NicairolMedinaPayano/nicairol0921/Tarea 6/Etiqueta.jpg

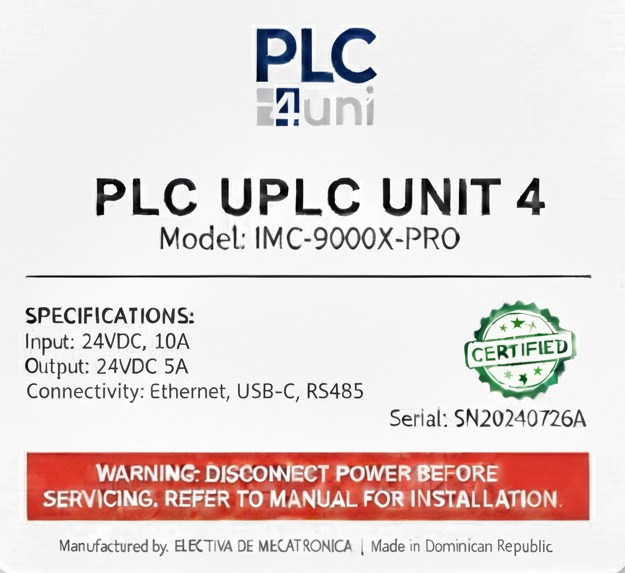
Tarea 6/Etiqueta.jpg
