NicairolMedinaPayano/nicairol0921/Tarea 1. Trabajo de investigación/DOC - Plantilla SRS ERS Norma IEEE-830 STD.docx

Especificación de requisitos de software

Proyecto: PLC 4 UNI

Revisión [99.99]

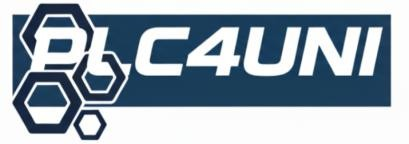
[picture p2: figure]

| 09/2025 [Mes de año]

Instrucciones para el uso de este formato

Este formato es una plantilla tipo para documentos de requisitos del software. Está basado y es conforme con el estándar IEEE Std 830-1998.

Las secciones que no se consideren aplicables al sistema descrito podrán de forma justificada indicarse como no aplicables (NA).

Notas:

Los textos en color azul son indicaciones que deben eliminarse y, en su caso, sustituirse por los contenidos descritos en cada apartado.

Los textos entre corchetes del tipo “[Inserte aquí el texto]” permiten la inclusión directa de texto con el color y estilo adecuado a la sección, al pulsar sobre ellos con el puntero del ratón.

Los títulos y subtítulos de cada apartado están definidos como estilos de MS Word, de forma que su numeración consecutiva se genera automáticamente según se trate de estilos “Titulo1, Titulo2 y Titulo3”.

La sangría de los textos dentro de cada apartado se genera automáticamente al pulsar Intro al final de la línea de título. (Estilos Normal indentado1, Normal indentado 2 y Normal indentado 3).

El índice del documento es una tabla de contenido que MS Word actualiza tomando como criterio los títulos del documento.

Una vez terminada su redacción debe indicarse a Word que actualice todo su contenido para reflejar el contenido definitivo.

De la plantilla de formato del documento © & Coloriuris http://www.qualitatis.org

# Ficha del documento

Fecha | Revisión | Autor | Verificado dep. calidad.
16/09/2025 | 16/09 | Nicairol Elian Medina Payano | [Firma o sello]

Documento validado por las partes en fecha: [Fecha]

Por el cliente | Por la empresa suministradora
Fdo. D./ Dña [Nombre] | Fdo. D./Dña [Nombre]

# Contenido

# 1 Introducción

El presente documento ofrece una descripción integral del sistema PLC 4 UNI, abarcando desde su propósito general hasta el funcionamiento operativo del sistema. La Especificación de Requisitos de Software (SRS) tiene como objetivo proporcionar una visión global del proyecto, definiendo su finalidad, alcance, terminología, referencias técnicas y estructura general.

Este documento consolida los requerimientos para el desarrollo de un Controlador Lógico Programable (PLC) diseñado con fines académicos, orientado a estudiantes que se inician en el campo de la automatización y el control industrial. Surge de la necesidad de disponer de una herramienta didáctica de bajo costo, confiable y sencilla de utilizar, que brinde la posibilidad de interactuar con un entorno de programación y control real.

El propósito fundamental del PLC 4 UNI es servir como un recurso formativo que fomente el aprendizaje práctico, permitiendo a los usuarios desarrollar, probar y depurar programas de control de manera dinámica e intuitiva. A diferencia de los controladores industriales convencionales —generalmente complejos y de alto costo—, este sistema busca trasladar la experiencia del entorno industrial al ámbito educativo, ofreciendo una plataforma accesible, funcional y adaptada a las necesidades de formación técnica y universitaria.

## 1.1 Propósito

El presente documento tiene como propósito establecer de manera precisa los requisitos funcionales y no funcionales del PLC 4 UNI, un controlador lógico programable de carácter educativo diseñado para facilitar el aprendizaje y la práctica de la automatización industrial de forma accesible y eficiente. Su objetivo principal es brindar una herramienta confiable y didáctica que combine simplicidad de uso con funcionalidades avanzadas propias de un entorno de control real.

Está orientado a los siguientes grupos de usuarios:

- Estudiantes de ingeniería, electrónica, mecatrónica y disciplinas afines, que utilizarán el PLC como instrumento de apoyo para la comprensión de conceptos de programación, control y lógica industrial.
- Docentes y tutores, quienes lo integrarán como recurso pedagógico en actividades prácticas, laboratorios y cursos de automatización.
- Desarrolladores e investigadores, interesados en optimizar o ampliar el diseño del sistema, contribuyendo a la evolución de futuras versiones del PLC.

## 1.2 Alcance

El proyecto PLC 4 UNI abarca el diseño, desarrollo e implementación de un Controlador Lógico Programable educativo, destinado a la enseñanza práctica de los fundamentos de la automatización y el control industrial. El sistema comprende tanto el hardware del dispositivo como el software de programación y simulación, garantizando una experiencia integral de aprendizaje.

El producto permitirá la creación, ejecución y monitoreo de rutinas lógicas orientadas al control de dispositivos eléctricos y electrónicos, utilizando una interfaz simplificada y segura. Su diseño busca ofrecer compatibilidad con componentes comunes de laboratorio, tales como sensores, actuadores y módulos de comunicación, manteniendo al mismo tiempo estándares de eficiencia, seguridad y estabilidad.

El alcance de este proyecto incluye:

- El desarrollo del entorno de programación del PLC 4 UNI, con soporte para programación gráfica y textual.
- La implementación del firmware embebido que gestionará las entradas, salidas, temporización y comunicación del sistema.
- La integración de módulos de simulación, que permitirán verificar el comportamiento de los programas sin requerir hardware externo.
- La documentación técnica, manuales de usuario y guías de prácticas educativas.

El PLC 4 UNI mantiene coherencia con descripciones funcionales y estructurales de documentos superiores del sistema, asegurando alineación con los objetivos académicos e institucionales establecidos para el aprendizaje de la automatización industrial.

## 1.3 Personal involucrado

Nombre | Equipo de Desarrollo PLC 4 UNI
Rol | Desarrollo del diseño y la interfaz del PLC
Categoría profesional | Ingeniería Mecatrónica
Responsabilidades | Diseñar la interfaz de usuario, definir la arquitectura del sistema y supervisar las etapas de desarrollo del hardware y software del PLC.
Información de contacto | 20212442@itla.edu.do
Aprobación | Prof. Carlos Pichardo Viuque

## 1.4 Definiciones, acrónimos y abreviaturas

PLC (Programmable Logic Controller / Controlador Lógico Programable): Dispositivo electrónico diseñado para automatizar procesos industriales mediante la ejecución de programas lógicos. En este proyecto, se emplea con fines educativos, replicando las funcionalidades de un PLC industrial real en un entorno didáctico.

Sensor: Elemento capaz de detectar variaciones en parámetros físicos o ambientales (como temperatura, presión, posición o luminosidad) y convertirlas en señales eléctricas interpretables por el PLC.

Actuador: Dispositivo electromecánico que recibe señales de salida desde el PLC y las convierte en acciones físicas, tales como encender luces, accionar relés, mover motores o abrir válvulas.

Interfaz de usuario (HMI - Human Machine Interface): Medio a través del cual el usuario interactúa con el sistema, visualizando estados, ingresando comandos y supervisando el funcionamiento del PLC.

Señales digitales: Entradas o salidas binarias que representan únicamente dos estados posibles (0 o 1), empleadas en la lógica de control secuencial y combinacional.

GUI (Graphical User Interface): Interfaz gráfica del software que permite la programación y supervisión del PLC mediante elementos visuales intuitivos, tales como botones, indicadores y bloques lógicos.

I/O (Input/Output): Término que hace referencia a los canales de entrada y salida del sistema, utilizados para la adquisición de datos y el control de dispositivos externos.

EDU (Educational): Clasificación del producto que indica su orientación didáctica, enfocada en la enseñanza de principios de automatización, control y programación lógica.

## 1.5 Referencias

Referencia | Titulo | Ruta | Fecha | Autor
1 | Manual del PLC educativo | /Documentos/PLC_Educativo/Manual.pdf | 01/09/2025 | Equipo de desarrollo
2 | Guía de programación de PLC | /Documentos/PLC_Educativo/Guía_Programación.pdf | 20/07/2025 | Equipo de desarrollo

## Resumen

Descripción del contenido:
El presente documento recopila de forma estructurada los requerimientos técnicos, funcionales y operativos del proyecto PLC 4 UNI. Incluye la definición de su propósito y alcance, la descripción del personal involucrado, los términos y acrónimos relevantes, las referencias técnicas, así como los requisitos funcionales y no funcionales que guían el desarrollo del sistema. También se detallan las características del entorno de programación, las interfaces de usuario y las especificaciones del hardware, garantizando una comprensión integral del sistema propuesto.

Organización del documento:
La información se encuentra organizada conforme a la norma IEEE Std 830-1998, iniciando con los apartados de introducción, propósito y alcance, seguidos de las definiciones, referencias y descripción general del producto. Posteriormente, se presentan los requisitos específicos —tanto funcionales como no funcionales—, los detalles de las interfaces, las restricciones y los anexos técnicos. Esta estructura permite al lector obtener una visión global, clara y coherente del PLC 4 UNI, su arquitectura, sus funcionalidades y su aplicación en entornos de enseñanza y desarrollo tecnológico.

# 2 Descripción general

## 2.1 Perspectiva del producto

- El PLC 4 UNI es un sistema autónomo e independiente, diseñado específicamente para la enseñanza práctica en el área de la automatización y el control industrial. Su arquitectura no depende de un sistema superior, aunque puede integrarse fácilmente con dispositivos complementarios como sensores, actuadores, módulos de simulación y software de programación, ampliando su funcionalidad dentro de entornos académicos y de laboratorio.
- El producto está orientado a proporcionar a los usuarios un entorno seguro, estable y de fácil interacción, que permita la comprensión de los principios de la lógica de control, la programación secuencial y el manejo de señales digitales y analógicas. Su interfaz de usuario intuitiva, junto con un diseño ergonómico y visualmente claro, garantiza una experiencia práctica que fomenta la exploración, la experimentación y la consolidación de conocimientos teóricos.

En conjunto, el PLC 4 UNI representa una herramienta formativa de alta utilidad para el desarrollo de competencias técnicas en automatización, control de procesos y electrónica aplicada, integrando la simplicidad de uso con capacidades funcionales propias de un sistema industrial de mediana escala.

## 2.2 Funcionalidad del producto

El PLC 4 UNI ha sido concebido como una herramienta práctica, robusta y didáctica que permite a los estudiantes comprender los principios fundamentales de la programación de controladores lógicos y la automatización de procesos. Su diseño combina una interfaz accesible con funcionalidades propias de un entorno industrial de tamaño reducido, optimizado para fines educativos y de experimentación.

Las principales funcionalidades del sistema son las siguientes:

- Programación básica y avanzada: El entorno de desarrollo del PLC 4 UNI permite la creación, edición y ejecución de programas de control mediante una interfaz intuitiva que soporta tanto programación gráfica (diagramas de escalera o bloques funcionales) como texto estructurado. Esto posibilita al usuario adquirir competencias progresivas en la lógica de control secuencial y combinacional.
- Gestión de entradas y salidas: El sistema dispone de módulos de entrada/salida digitales y analógicas que permiten la conexión directa con sensores y actuadores. Reconoce señales provenientes de dispositivos de detección (como interruptores, sensores de temperatura o proximidad) y genera señales de salida para el control de elementos tales como motores, relés, válvulas o indicadores luminosos, garantizando precisión y respuesta en tiempo real.
- Simulación de procesos: Incluye un módulo de simulación integrada que permite validar programas sin necesidad de hardware externo, facilitando la enseñanza y las pruebas de lógica antes de la implementación física.
- Supervisión y diagnóstico: El software incorpora herramientas de monitoreo para la visualización de estados de E/S, seguimiento de variables, registro de eventos y diagnóstico de errores, lo cual mejora la trazabilidad y el aprendizaje del comportamiento del sistema.

En conjunto, estas funcionalidades posicionan al PLC 4 UNI como una plataforma de formación versátil y completa, capaz de reproducir las condiciones operativas de un PLC industrial dentro de un entorno educativo controlado.

## 2.3 Características de los usuarios

Tipo de usuario
Formación
Habilidades
Actividades

Descripción de los usuarios del producto, incluyendo nivel educacional, experiencia y experiencia técnica.

## 2.4 Restricciones

## 2.5 Suposiciones y dependencias

## 2.6 Evolución previsible del sistema

# 3 Requisitos específicos

Esta es la sección más extensa y más importante del documento.

Debe contener una lista detallada y completa de los requisitos que debe cumplir el sistema a desarrollar. El nivel de detalle de los requisitos debe ser el suficiente para que el equipo de desarrollo pueda diseñar un sistema que satisfaga los requisitos y los encargados de las pruebas puedan determinar si éstos se satisfacen.

Los requisitos se dispondrán en forma de listas numeradas para su identificación, seguimiento, trazabilidad y validación (ej. RF 10, RF 10.1, RF 10.2,...).

Para cada requisito debe completarse la siguiente tabla:

Número de requisito | RF-027
Nombre de requisito | Entradas digitales configurables
Tipo | Requisito | Restricción
Fuente del requisito | Necesidad educativa / prácticas de control básico
Prioridad del requisito | Alta/Esencial | Media/Deseado | Baja/ Opcional

y realizar la descripción del requisito

La distribución de los párrafos que forman este punto puede diferir del propuesto en esta plantilla, si las características del sistema aconsejan otra distribución para ofrecer mayor claridad en la exposición.

## 3.1 Requisitos comunes de los interfaces

[Inserte aquí el texto]

Descripción detallada de todas las entradas y salidas del sistema de software.

### 3.1.1 Interfaces de usuario

### 3.1.2 Interfaces de hardware

### 3.1.3 Interfaces de software

### 3.1.4 Interfaces de comunicación

## 3.2 Requisitos funcionales

### 3.2.1 Requisito funcional 1

### 3.2.2 Requisito funcional 2

### 3.2.3 Requisito funcional 3

### 3.2.4 Requisito funcional n

## 3.3 Requisitos no funcionales

### 3.3.1 Requisitos de rendimiento

### 3.3.2 Seguridad

### 3.3.3 Fiabilidad

### 3.3.4 Disponibilidad

### 3.3.5 Mantenibilidad

### 3.3.6 Portabilidad

## 3.4 Otros requisitos

### 4. Apéndice

Descripción de requisitos del sofware

Rev. [99.99] Pág. 10 PLC 4 UNI
