NicairolMedinaPayano/nicairol0921/Tarea 5/2.jpg

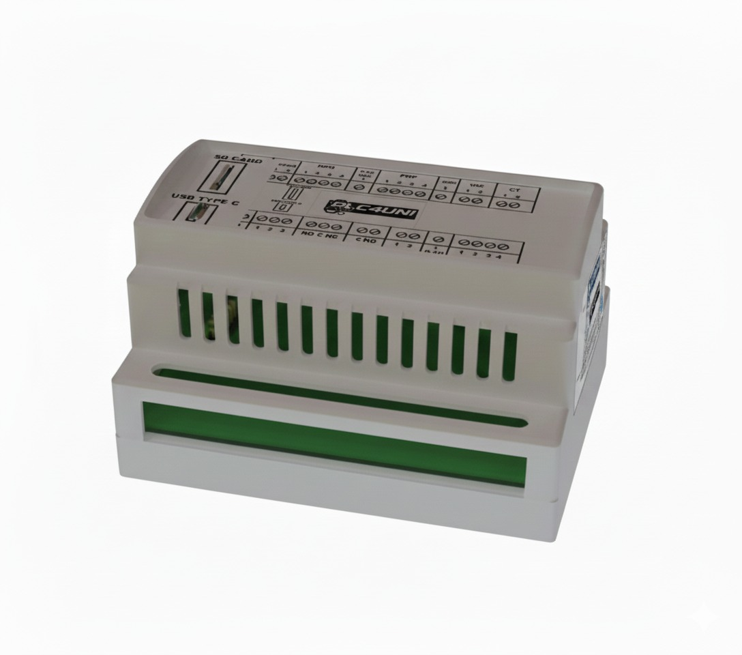
Tarea 5/2.jpg
