NicairolMedinaPayano/nicairol0921/Tarea 6/1.jpg

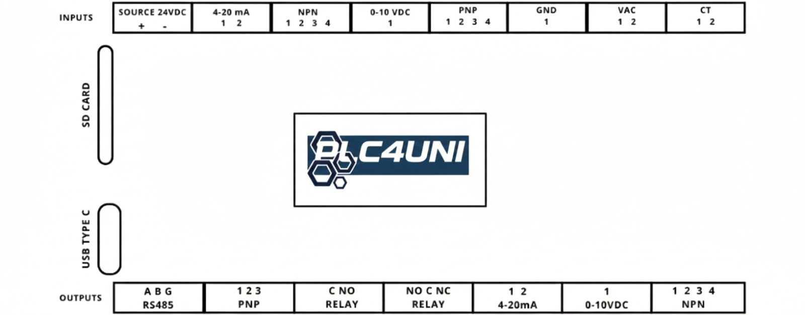
Tarea 6/1.jpg
