NicairolMedinaPayano/nicairol0921/Tarea 6/Ensamble DE NICAIROL MEDINA.FCStd

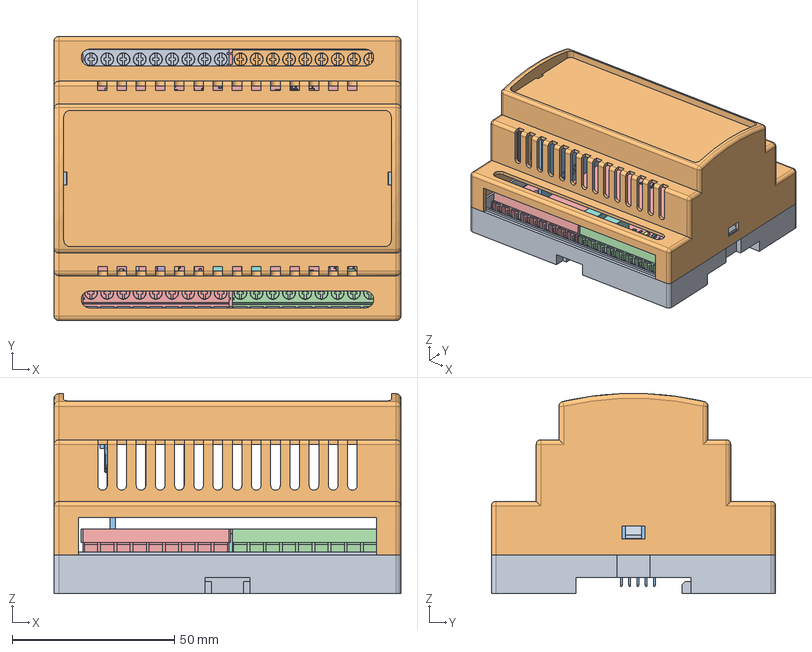
[picture p5: CAD file, 2025-12-12]
Tarea 6/Ensamble DE NICAIROL MEDINA.FCStd
107.0 x 87.7 x 61.7 mm
Tapa
Cuerpov2_001
Ensamble PCB Vertical1_001
R_0603_1608Metric
C_0603_1608Metric
R_0603_1608Metric001
C_1206_3216Metric
R_0603_1608Metric002
R_0603_1608Metric003
C_0805_2012Metric
R_0603_1608Metric004
SSOP-10-1EP_3.9x4.9mm_P1mm_EP2.1x3.3mm
R_0603_1608Metric005
R_0603_1608Metric006
R_0603_1608Metric007
R_0603_1608Metric008
ESOP-8_L4.9-W3.9-H1.6-LS6.0-P1.27
ESOP-8_L4.9-W3.9-H1.6-LS6.0-P1.028
ESOP-8_L4.9-W3.9-H1.6-LS6.0-P1.029
ESOP-8_L4.9-W3.9-H1.6-LS6.0-P1.030
ESOP-8_L4.9-W3.9-H1.6-LS6.0-P1.031
ESOP-8_L4.9-W3.9-H1.6-LS6.0-P1.032
ESOP-8_L4.9-W3.9-H1.6-LS6.0-P1.033
ESOP-8_L4.9-W3.9-H1.6-LS6.0-P1.034
ESOP-8_L4.9-W3.9-H1.6-LS6.0-P1.035
ESOP-8_L4.9-W3.9-H1.6-LS6.0-P1.036
ESOP-8_L4.9-W3.9-H1.6-LS6.0-P1.037
ESOP-8_L4.9-W3.9-H1.6-LS6.0-P1.038
ESOP-8_L4.9-W3.9-H1.6-LS6.0-P1.039
ESOP-8_L4.9-W3.9-H1.6-LS6.0-P1.040
ESOP-8_L4.9-W3.9-H1.6-LS6.0-P1.041
ESOP-8_L4.9-W3.9-H1.6-LS6.0-P1.042
ESOP-8_L4.9-W3.9-H1.6-LS6.0-P1.043
ESOP-8_L4.9-W3.9-H1.6-LS6.0-P1.044
ESOP-8_L4.9-W3.9-H1.6-LS6.0-P1.045
ESOP-8_L4.9-W3.9-H1.6-LS6.0-P1.046
ESOP-8_L4.9-W3.9-H1.6-LS6.0-P1.047
ESOP-8_L4.9-W3.9-H1.6-LS6.0-P1.048
R_0603_1608Metric009
R_0603_1608Metric010
SOIC-8_3.9x4.9mm_P1.27mm
D_SMA
C_1206_3216Metric001
R_0603_1608Metric011
SOT-23
C_0603_1608Metric001
R_0603_1608Metric012
C_0805_2012Metric001
SOT-024
R_0603_1608Metric013
C_0603_1608Metric002
R_0603_1608Metric014
SOP-4_4.4x2.6mm_P1.27mm
R_0603_1608Metric015
C_0201_0603Metric
D_SMF
R_0603_1608Metric016
SOP-4_4.4x2.6mm_P1.27mm001
L_APV_ANR4030
SOT-025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
