NicairolMedinaPayano/nicairol0921/Tarea 4/Ensamble.FCStd

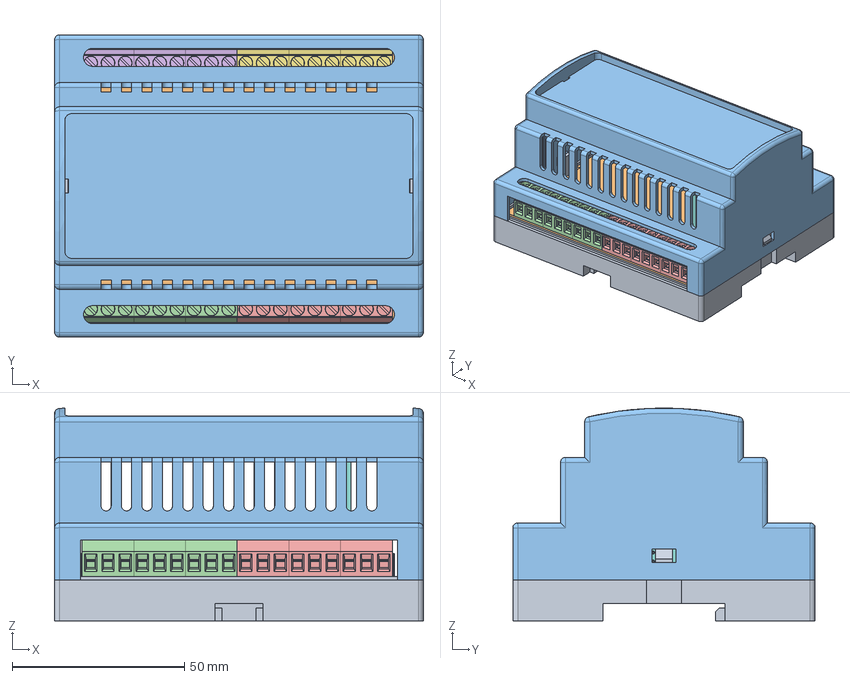
[picture p6: CAD file, 2025-12-12]
Tarea 4/Ensamble.FCStd
107.0 x 87.7 x 61.7 mm
Tapav2_001
PLC4UNIPCB1_001
Cuerpov2_001
pxc_1715718_04_01_MKDS-1-5-9_3D1_001
pxc_1715718_04_01_MKDS-1-5-9_3D1_002
pxc_1715718_04_01_MKDS-1-5-9_3D1_003
pxc_1715718_04_01_MKDS-1-5-9_3D1_004
Ensamble PCB Vertical1_001
