NicairolMedinaPayano/nicairol0921/Tarea 2/Emsabajes y Diseños de Case. SE y FCAD/FreeCAD paramétrico/Parte 1.FCStd

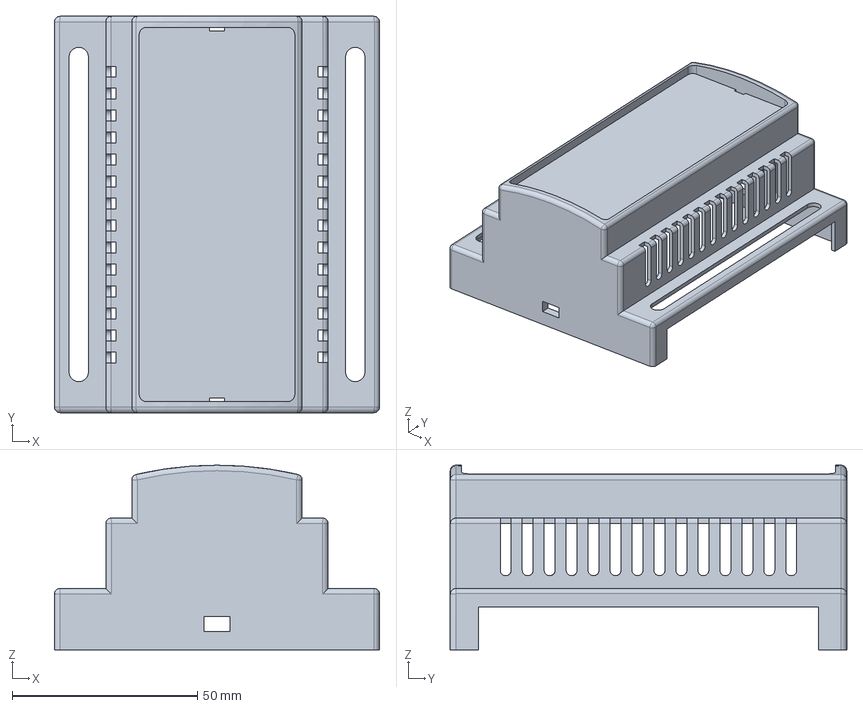
[picture p7: CAD file, 2025-10-11]
Tarea 2/Emsabajes y Diseños de Case. SE y FCAD/FreeCAD paramétrico/Parte 1.FCStd
87.7 x 107.0 x 49.8 mm
