NicairolMedinaPayano/nicairol0921/Tarea 4/Cuerpov2.FCStd

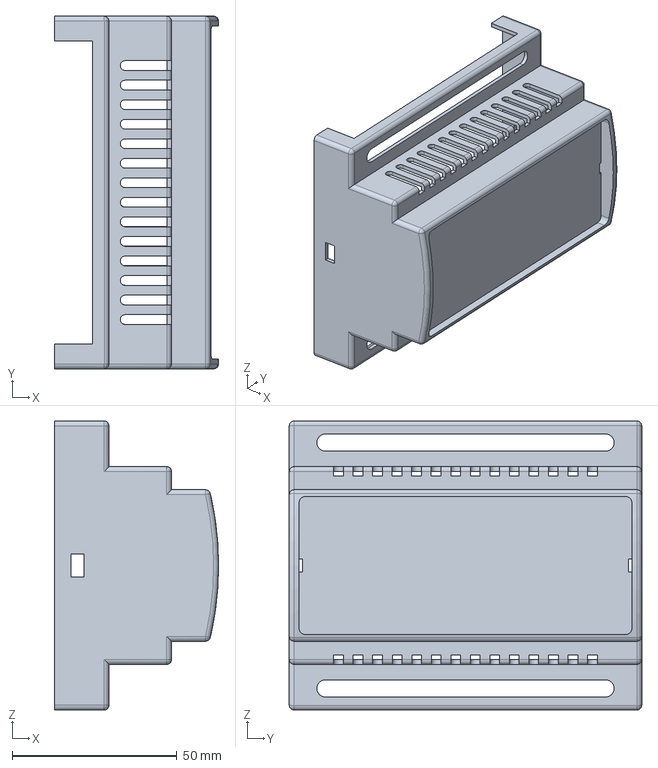
[picture p8: CAD file, 2025-12-12]
Tarea 4/Cuerpov2.FCStd
49.8 x 107.0 x 87.7 mm
