NicairolMedinaPayano/nicairol0921/Tarea 2/Emsabajes y Diseños de Case. SE y FCAD/FreeCAD paramétrico/Parte 3.FCStd

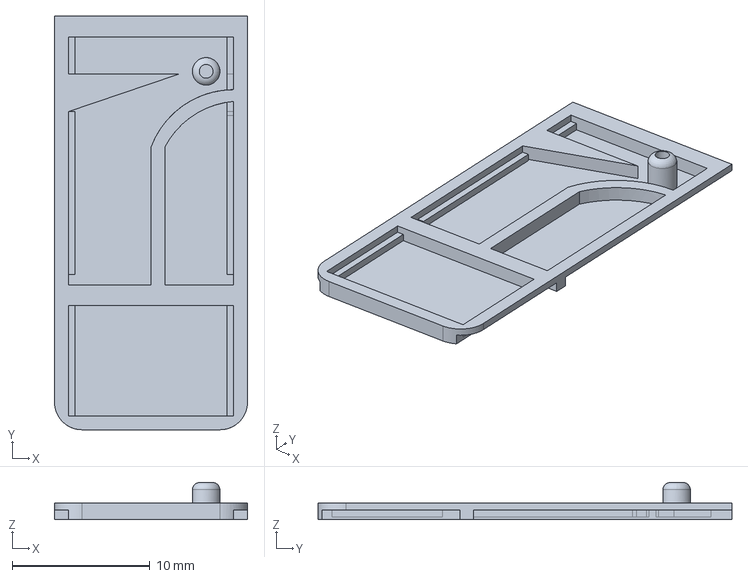
[picture p9: CAD file, 2025-10-11]
Tarea 2/Emsabajes y Diseños de Case. SE y FCAD/FreeCAD paramétrico/Parte 3.FCStd
14.0 x 30.0 x 2.70 mm
