NicairolMedinaPayano/nicairol0921/Tarea 2/Emsabajes y Diseños de Case. SE y FCAD/FreeCAD paramétrico/Parte 2.FCStd

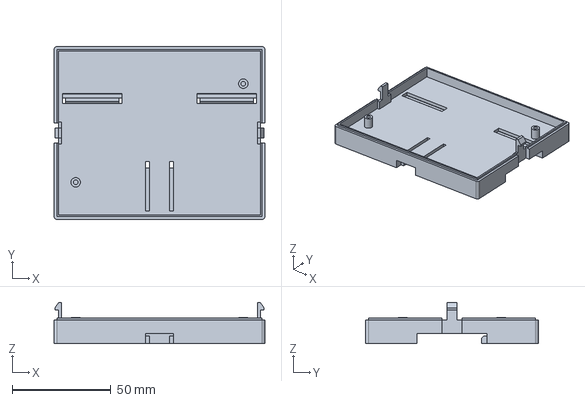
[picture p10: CAD file, 2025-10-11]
Tarea 2/Emsabajes y Diseños de Case. SE y FCAD/FreeCAD paramétrico/Parte 2.FCStd
107.0 x 87.7 x 20.8 mm
