NicairolMedinaPayano/nicairol0921/Tarea 4/PCB4UNIFREECAD.FCStd

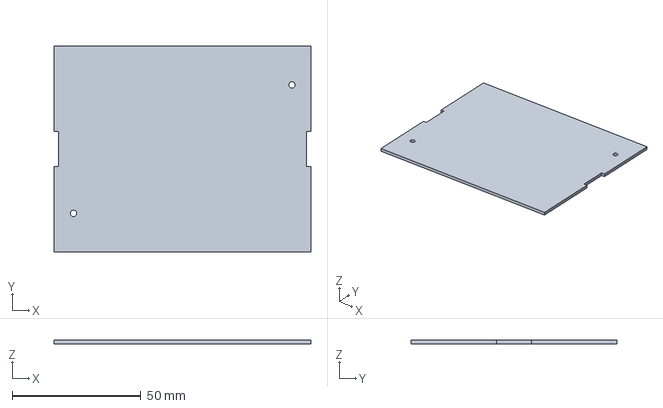
[picture p11: CAD file, 2025-12-12]
Tarea 4/PCB4UNIFREECAD.FCStd
100.0 x 80.2 x 1.51 mm
