NicairolMedinaPayano/nicairol0921/Tarea 4/Male Pin Header Angle.STEP

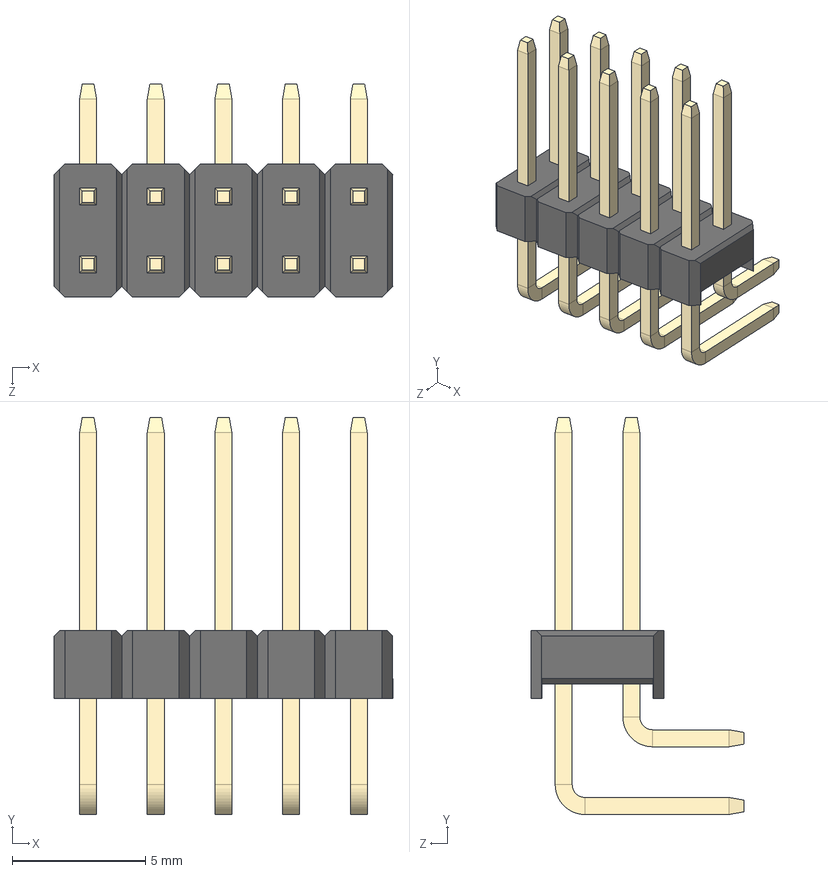
[picture p12: CAD file, 2025-12-12]
Tarea 4/Male Pin Header Angle.STEP
12.7 x 14.9 x 8.00 mm
