NicairolMedinaPayano/nicairol0921/(list of files, cad)

Other CAD files:
Tarea 4/Case.FCStd
Tarea 4/Ensamble (2).FCStd
