NicairolMedinaPayano/nicairol0921/Tarea 4/RS/RS CON PROT/RS CON PROT.kicad_pcb

## KiCad design Tarea 4/RS/RS CON PROT/RS CON PROT.kicad_pcb (2025-12-12)

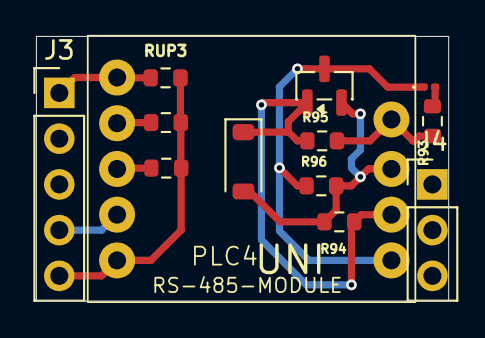
[picture p33: board RS CON PROT.kicad_pcb from above]

Board: 4 copper layers, 22.9 x 14.7 mm, 13 parts (0 on the bottom side), 10 nets.

Parts:
D712: SM712_SOT23; SOT-23
DL1: LED; LED_0201_0603Metric
DTV1: D_TVS; D_SOD-123
J3: Conn_01x05; PinHeader_1x05_P2.54mm_Vertical
J4: Conn_01x03; PinHeader_1x03_P2.54mm_Vertical
R93, R94, R95, R96: R_US; R_0603_1608Metric
RUP1, RUP2, RUP3: R_US; R_0603_1608Metric
U0: RS485-MODULE-DEVO NU

Connections:
+3.3V: J3.1, RUP1.1, RUP2.1, RUP3.1, U0.1 (VCC)
/RS_mod_pro/RS_485-A: D712.1 (A1), DTV1.1 (A1), J4.9 (Pin_2), R94.2, R95.2, U0.9 (A)
/RS_mod_pro/RS_485-B: D712.2 (A2), DTV1.2 (A2), J4.8 (Pin_1), R94.1, R96.2, U0.8 (B)
/RS_mod_pro/UART_IN: J3.4, RUP2.2, U0.4 (RX)
/RS_mod_pro/UART_OUT: J3.3, RUP1.2, U0.3 (TX)
Earth: J3.2, U0.2 (GND)
unnamed: D712.3 (common), DL1.1 (K), J4.10 (Pin_3), R96.1, U0.10 (RGND)
unnamed: DL1.2 (A), R93.2
unnamed: J3.5, RUP3.2, U0.5 (CON)
unnamed: R93.1, R95.1, U0.7 (VO)
