NicairolMedinaPayano/nicairol0921/Tarea 4/PLC4UNI_Board.kicad_pcb

## KiCad design Tarea 4/PLC4UNI_Board.kicad_pcb (2025-12-12)

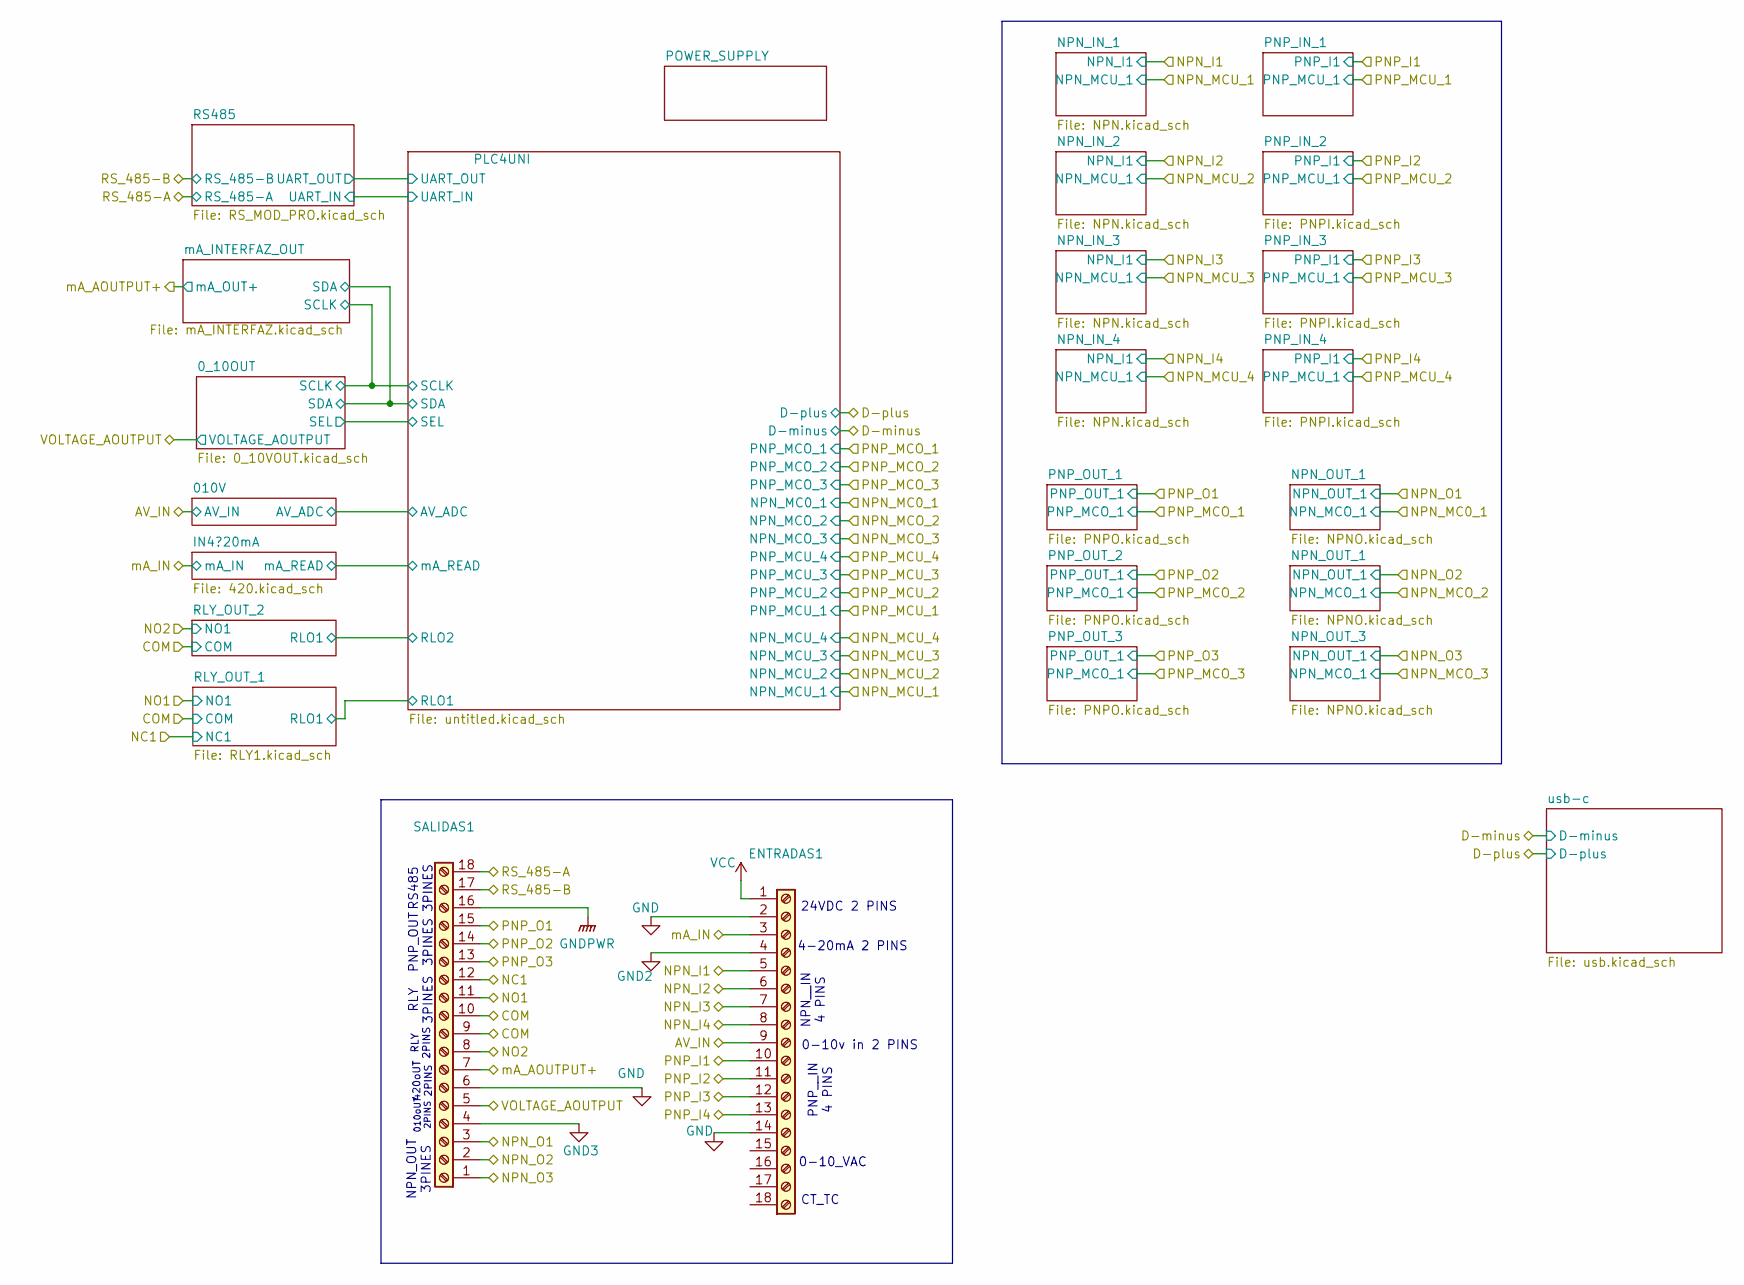
[picture p34: schematic PLC4UNI_Board.kicad_sch]

Parts:
ENTRADAS1: Screw_Terminal_01x18; TerminalBlock_MaiXu_MX126-5.0-18P_1x18_P5.00mm
SALIDAS1: Screw_Terminal_01x18; TerminalBlock_MaiXu_MX126-5.0-18P_1x18_P5.00mm

Connections:
/AV_IN: ENTRADAS1.9 (Pin_10); also elsewhere on the board
/COM: SALIDAS1.9, SALIDAS1.10; also elsewhere on the board
/NC1: SALIDAS1.12 (7); also elsewhere on the board
/NO1: SALIDAS1.11; also elsewhere on the board
/NO2: SALIDAS1.8; also elsewhere on the board
/NPN_I1: ENTRADAS1.5 (Pin_14); also elsewhere on the board
/NPN_I2: ENTRADAS1.6 (Pin_13); also elsewhere on the board
/NPN_I3: ENTRADAS1.7 (Pin_12); also elsewhere on the board
/NPN_I4: ENTRADAS1.8 (Pin_11); also elsewhere on the board
/NPN_O1: SALIDAS1.3; also elsewhere on the board
/NPN_O2: SALIDAS1.2; also elsewhere on the board
/NPN_O3: SALIDAS1.1; also elsewhere on the board
/PNP_I1: ENTRADAS1.10 (Pin_9); also elsewhere on the board
/PNP_I2: ENTRADAS1.11 (Pin_8); also elsewhere on the board
/PNP_I3: ENTRADAS1.12 (Pin_7); also elsewhere on the board
/PNP_I4: ENTRADAS1.13 (Pin_6); also elsewhere on the board
/PNP_O1: SALIDAS1.15; also elsewhere on the board
/PNP_O2: SALIDAS1.14; also elsewhere on the board
/PNP_O3: SALIDAS1.13; also elsewhere on the board
/RS_485-A: SALIDAS1.18; also elsewhere on the board
/RS_485-B: SALIDAS1.17; also elsewhere on the board
/VOLTAGE_AOUTPUT: SALIDAS1.5; also elsewhere on the board
/mA_AOUTPUT+: SALIDAS1.7; also elsewhere on the board
/mA_IN: ENTRADAS1.3 (Pin_16); also elsewhere on the board
GND: ENTRADAS1.2 (Pin_17), ENTRADAS1.14 (Pin_5), SALIDAS1.6; also elsewhere on the board
GND2: ENTRADAS1.4 (Pin_15); also elsewhere on the board
GND3: SALIDAS1.4; also elsewhere on the board
GNDPWR: SALIDAS1.16; also elsewhere on the board
VCC: ENTRADAS1.1 (Pin_18); also elsewhere on the board

Notes on the sheet:
4-20mA 2 PINS
0-10_VAC
NPN_OUT 3PINES
010oUT 2PINS
0-10v in 2 PINS
PNP_OUT 3PINES
CT_TC
PNP__IN 4 PINS
RS485 3PINES
NPN__IN 4 PINS
RLY 2PINS
RLY 3PINES
24VDC 2 PINS
420oUT 2PINS

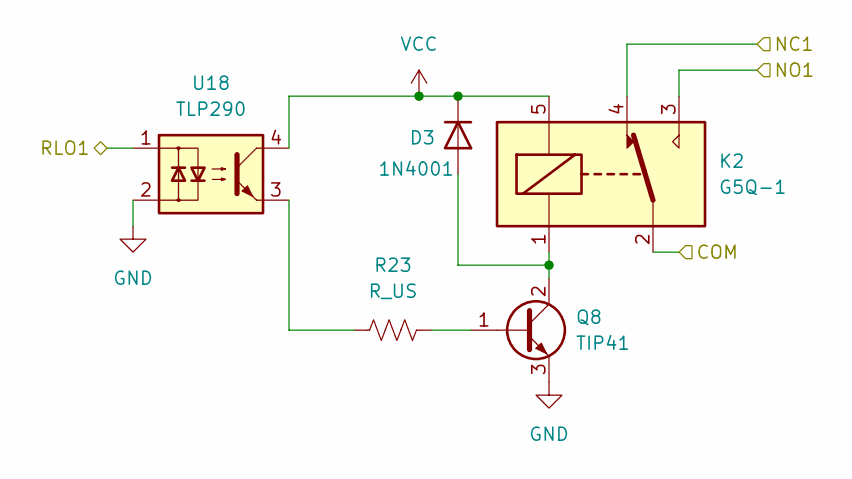
[picture p35: schematic RLY1.kicad_sch]

Parts:
D3: 1N4001; D_DO-41_SOD81_P10.16mm_Horizontal
K2: G5Q-1; Relay_SPDT_Omron-G5Q-1
Q8: TIP41; TO-252-2
R23: R_US; R_0201_0603Metric
U18: TLP290; SOP-4_4.4x2.6mm_P1.27mm

Connections:
/COM: K2.2; also elsewhere on the board
/NO2: K2.3; also elsewhere on the board
/PLC4UNI/RLO2: U18.1; also elsewhere on the board
/RLY_OUT_2/NC1: K2.4
GND: Q8.3 (E), U18.2; also elsewhere on the board
unnamed: D3.2 (A), K2.1, Q8.2 (C)
unnamed: Q8.1 (B), R23.2
unnamed: R23.1, U18.3
VCC: D3.1 (K), K2.5, U18.4; also elsewhere on the board

Parts of its further copies:
D1: 1N4001; D_DO-41_SOD81_P10.16mm_Horizontal
K1: G5Q-1; Relay_SPDT_Omron-G5Q-1
Q7: TIP41; TO-252-2
R22: R_US; R_0201_0603Metric
U17: TLP290; SOP-4_4.4x2.6mm_P1.27mm

Connections of its further copies:
/COM: K1.2; also elsewhere on the board
/NC1: K1.4; also elsewhere on the board
/NO1: K1.3; also elsewhere on the board
/PLC4UNI/RLO1: U17.1; also elsewhere on the board
GND: Q7.3 (E), U17.2; also elsewhere on the board
unnamed: D1.2 (A), K1.1, Q7.2 (C)
unnamed: Q7.1 (B), R22.2
unnamed: R22.1, U17.3
VCC: D1.1 (K), K1.5, U17.4; also elsewhere on the board

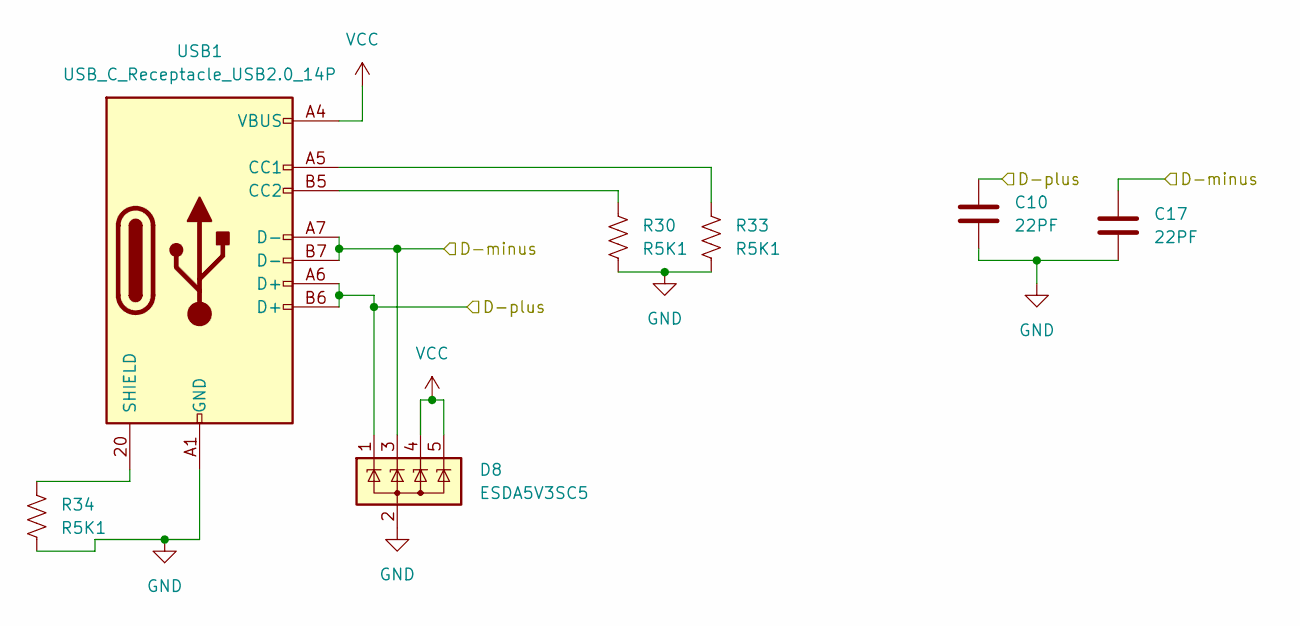
[picture p36: schematic usb.kicad_sch]

Parts:
C10, C17: 22PF; C_0603_1608Metric
D8: ESDA5V3SC5; SOT-23-5
R30, R33, R34: R5K1; R_0201_0603Metric
USB1: USB_C_Receptacle_USB2.0_14P; USB-C-TH_HX-TYPE-C-16P-180-LC-BH10.0-TYPE-C-VERTICAL

Connections:
/D-minus: C17.1, D8.3 (K), USB1.A7 (D-), USB1.B7 (D-); also elsewhere on the board
/D-plus: C10.1, D8.1 (K), USB1.A6 (D+), USB1.B6 (D+); also elsewhere on the board
GND: C10.2, C17.2, D8.2 (A), R30.2, R33.2, R34.2, USB1.A1 (GND), USB1.A12 (GND), USB1.B1 (GND), USB1.B12 (GND); also elsewhere on the board
unnamed: R33.1, USB1.A5 (CC1)
unnamed: R30.1, USB1.B5 (CC2)
unnamed: R34.1, USB1.20 (SHIELD)
VCC: D8.4 (K), D8.5 (K), USB1.A4 (VBUS), USB1.A9 (VBUS), USB1.B4 (VBUS), USB1.B9 (VBUS); also elsewhere on the board

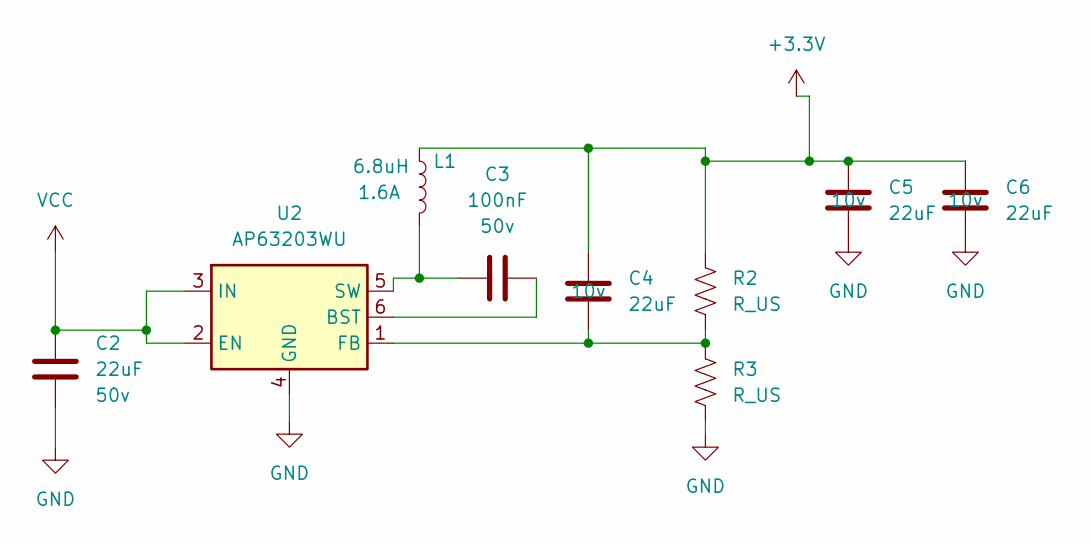
[picture p37: schematic PSU_sch.kicad_sch]

Parts:
C2: 22uF; C_1206_3216Metric
C3: 100nF; C_0201_0603Metric
C4: 22uF; C_1206_3216Metric_Pad1.33x1.80mm_HandSolder
C5, C6: 22uF; C_0805_2012Metric_Pad1.18x1.45mm_HandSolder
L1: 6.8uH_1.0A_4018; L_APV_ANR6028; Part Number NRS4018T6R8MDGJ; JLCPCB ID C223055
R2, R3: R_US; R_0201_0603Metric
U2: AP63203WU; TSOT-23-6

Connections:
+3.3V: C4.1, C5.1, C6.1, L1.1, R2.1; also elsewhere on the board
GND: C2.2, C5.2, C6.2, R3.2, U2.4 (GND); also elsewhere on the board
unnamed: C3.2, U2.6 (BST)
unnamed: C4.2, R2.2, R3.1, U2.1 (FB)
unnamed: C3.1, L1.2, U2.5 (SW)
VCC: C2.1, U2.2 (EN), U2.3 (IN); also elsewhere on the board

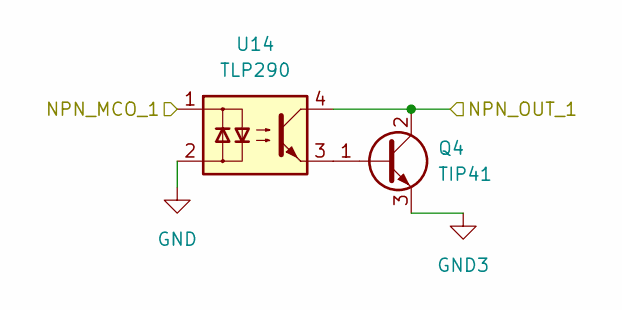
[picture p38: schematic NPNO.kicad_sch]

Parts:
Q4: TIP41; TO-252-2
U14: TLP290; SOP-4_4.4x2.6mm_P1.27mm

Connections:
/NPN_MCO_2: U14.1; also elsewhere on the board
/NPN_O2: Q4.2 (C), U14.4; also elsewhere on the board
GND: U14.2; also elsewhere on the board
GND3: Q4.3 (E); also elsewhere on the board
unnamed: Q4.1 (B), U14.3

Parts of its further copies:
Q5, Q6: TIP41; TO-252-2
U15, U16: TLP290; SOP-4_4.4x2.6mm_P1.27mm

Connections of its further copies:
/NPN_MC0_1: U16.1; also elsewhere on the board
/NPN_MCO_3: U15.1; also elsewhere on the board
/NPN_O1: Q6.2 (C), U16.4; also elsewhere on the board
/NPN_O3: Q5.2 (C), U15.4; also elsewhere on the board
GND: U15.2, U16.2; also elsewhere on the board
GND3: Q5.3 (E), Q6.3 (E); also elsewhere on the board
unnamed: Q5.1 (B), U15.3
unnamed: Q6.1 (B), U16.3

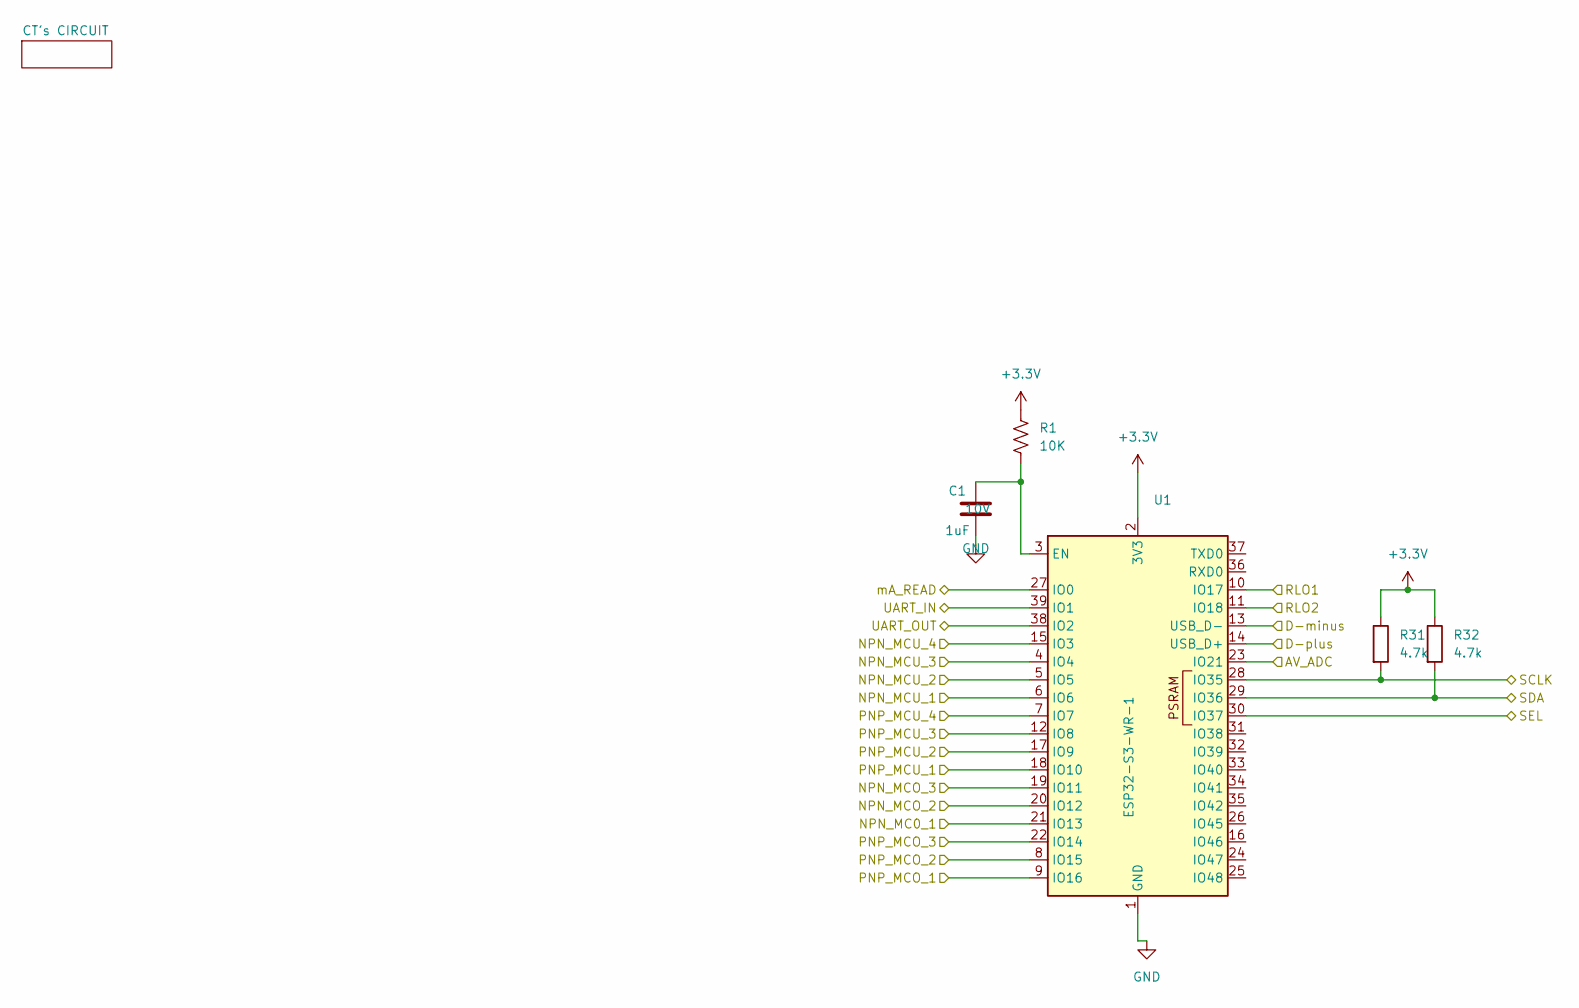
[picture p39: schematic untitled.kicad_sch]

Parts:
C1: 1uF; C_1206_3216Metric_Pad1.33x1.80mm_HandSolder
R1: 10K; R_0201_0603Metric
R31, R32: 4.7k; R_0603_1608Metric
U1: ESP32-S3-WR-1; ESP32-S3-WROOM-1

Connections:
+3.3V: R1.1, R31.1, R32.1, U1.2 (3V3); also elsewhere on the board
/0_10OUT/SCLK: R31.2, U1.28 (IO35); also elsewhere on the board
/0_10OUT/SDA: R32.2, U1.29 (IO36); also elsewhere on the board
/0_10OUT/SEL: U1.30 (IO37); also elsewhere on the board
/010V/AV_ADC: U1.23 (IO21); also elsewhere on the board
/D-minus: U1.13 (USB_D-); also elsewhere on the board
/D-plus: U1.14 (USB_D+); also elsewhere on the board
/NPN_MC0_1: U1.21 (IO13); also elsewhere on the board
/NPN_MCO_2: U1.20 (IO12); also elsewhere on the board
/NPN_MCO_3: U1.19 (IO11); also elsewhere on the board
/NPN_MCU_1: U1.6 (IO6); also elsewhere on the board
/NPN_MCU_2: U1.5 (IO5); also elsewhere on the board
/NPN_MCU_3: U1.4 (IO4); also elsewhere on the board
/NPN_MCU_4: U1.15 (IO3); also elsewhere on the board
/PLC4UNI/RLO1: U1.10 (IO17); also elsewhere on the board
/PLC4UNI/RLO2: U1.11 (IO18); also elsewhere on the board
/PLC4UNI/UART_IN: U1.39 (IO1); also elsewhere on the board
/PLC4UNI/UART_OUT: U1.38 (IO2); also elsewhere on the board
/PNP_MCO_1: U1.9 (IO16); also elsewhere on the board
/PNP_MCO_2: U1.8 (IO15); also elsewhere on the board
/PNP_MCO_3: U1.22 (IO14); also elsewhere on the board
/PNP_MCU_1: U1.18 (IO10); also elsewhere on the board
/PNP_MCU_2: U1.17 (IO9); also elsewhere on the board
/PNP_MCU_3: U1.12 (IO8); also elsewhere on the board
/PNP_MCU_4: U1.7 (IO7); also elsewhere on the board
/mA_IN: U1.27 (IO0); also elsewhere on the board
GND: C1.2, U1.1 (GND), U1.40 (GND), U1.41 (GND); also elsewhere on the board
unnamed: C1.1, R1.2, U1.3 (EN)

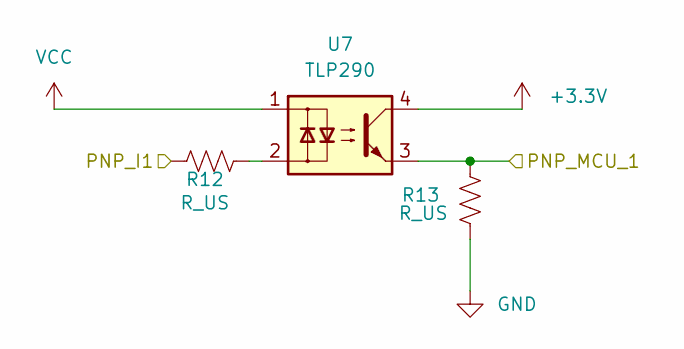
[picture p40: schematic PNPI.kicad_sch]

Parts:
R12: R_US; R_0603_1608Metric
R13: R_US; R_0201_0603Metric
U7: TLP290; SOP-4_4.4x2.6mm_P1.27mm

Connections:
+3.3V: U7.4; also elsewhere on the board
/PNP_I1: R12.1; also elsewhere on the board
/PNP_MCU_1: R13.1, U7.3; also elsewhere on the board
GND: R13.2; also elsewhere on the board
unnamed: R12.2, U7.2
VCC: U7.1; also elsewhere on the board

Parts of its further copies:
R14, R16, R18: R_US; R_0603_1608Metric
R15, R17, R19: R_US; R_0201_0603Metric
U8, U9, U10: TLP290; SOP-4_4.4x2.6mm_P1.27mm

Connections of its further copies:
+3.3V: U8.4, U9.4, U10.4; also elsewhere on the board
/PNP_I2: R14.1; also elsewhere on the board
/PNP_I3: R16.1; also elsewhere on the board
/PNP_I4: R18.1; also elsewhere on the board
/PNP_MCU_2: R15.1, U8.3; also elsewhere on the board
/PNP_MCU_3: R17.1, U9.3; also elsewhere on the board
/PNP_MCU_4: R19.1, U10.3; also elsewhere on the board
GND: R15.2, R17.2, R19.2; also elsewhere on the board
unnamed: R14.2, U8.2
unnamed: R16.2, U9.2
unnamed: R18.2, U10.2
VCC: U8.1, U9.1, U10.1; also elsewhere on the board

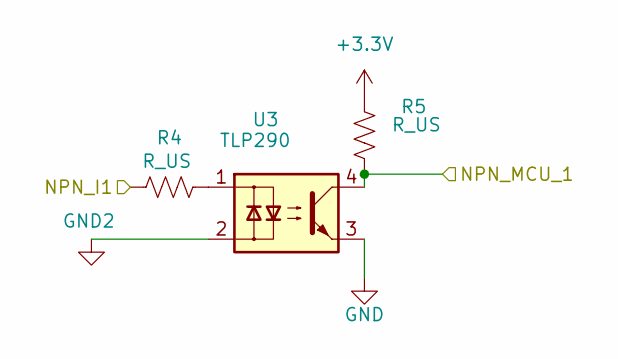
[picture p41: schematic NPN.kicad_sch]

Parts:
R4, R5: R_US; R_0201_0603Metric
U3: TLP290; SOP-4_4.4x2.6mm_P1.27mm

Connections:
+3.3V: R5.1; also elsewhere on the board
/NPN_I1: R4.1; also elsewhere on the board
/NPN_MCU_1: R5.2, U3.4; also elsewhere on the board
GND: U3.3; also elsewhere on the board
GND2: U3.2; also elsewhere on the board
unnamed: R4.2, U3.1

Parts of its further copies:
R6, R7, R8, R9, R10, R11: R_US; R_0201_0603Metric
U4, U5, U6: TLP290; SOP-4_4.4x2.6mm_P1.27mm

Connections of its further copies:
+3.3V: R7.1, R9.1, R11.1; also elsewhere on the board
/NPN_I2: R6.1; also elsewhere on the board
/NPN_I3: R8.1; also elsewhere on the board
/NPN_I4: R10.1; also elsewhere on the board
/NPN_MCU_2: R7.2, U4.4; also elsewhere on the board
/NPN_MCU_3: R9.2, U5.4; also elsewhere on the board
/NPN_MCU_4: R11.2, U6.4; also elsewhere on the board
GND: U4.3, U5.3, U6.3; also elsewhere on the board
GND2: U4.2, U5.2, U6.2; also elsewhere on the board
unnamed: R6.2, U4.1
unnamed: R8.2, U5.1
unnamed: R10.2, U6.1

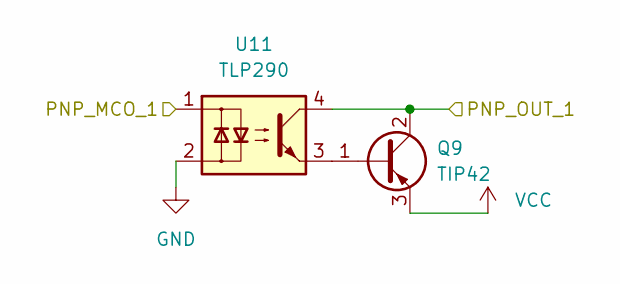
[picture p42: schematic PNPO.kicad_sch]

Parts:
Q9: TIP42; TO-252-2
U11: TLP290; SOP-4_4.4x2.6mm_P1.27mm

Connections:
/PNP_MCO_2: U11.1; also elsewhere on the board
/PNP_O2: Q9.2 (C), U11.4; also elsewhere on the board
GND: U11.2; also elsewhere on the board
unnamed: Q9.1 (B), U11.3
VCC: Q9.3 (E); also elsewhere on the board

Parts of its further copies:
Q10, Q11: TIP42; TO-252-2
U12, U13: TLP290; SOP-4_4.4x2.6mm_P1.27mm

Connections of its further copies:
/PNP_MCO_1: U13.1; also elsewhere on the board
/PNP_MCO_3: U12.1; also elsewhere on the board
/PNP_O1: Q11.2 (C), U13.4; also elsewhere on the board
/PNP_O3: Q10.2 (C), U12.4; also elsewhere on the board
GND: U12.2, U13.2; also elsewhere on the board
unnamed: Q10.1 (B), U12.3
unnamed: Q11.1 (B), U13.3
VCC: Q10.3 (E), Q11.3 (E); also elsewhere on the board

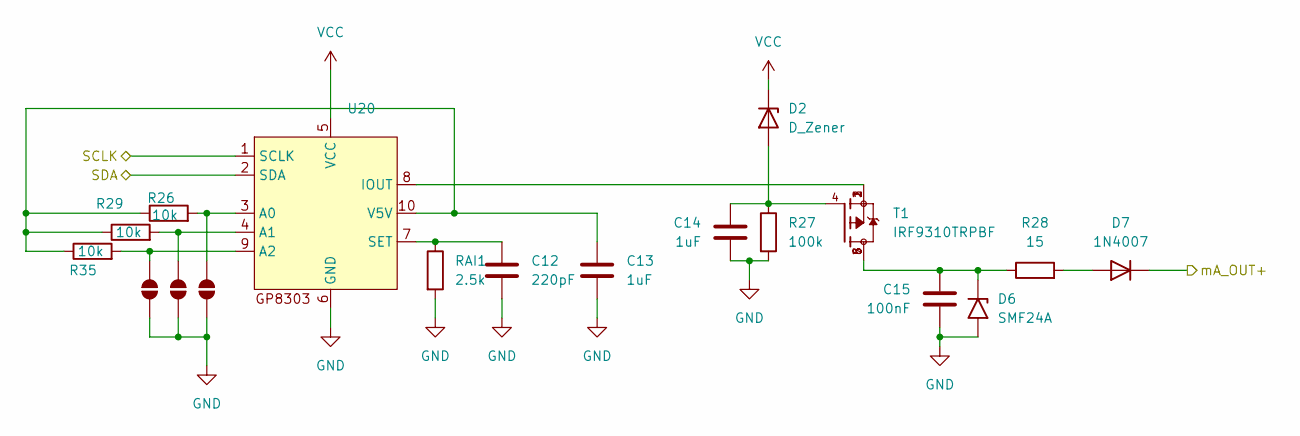
[picture p43: schematic mA_INTERFAZ.kicad_sch]

Parts:
C12: 220pF; C_0805_2012Metric
C13, C14: 1uF; C_0805_2012Metric
C15: 100nF; C_0805_2012Metric
D2: D_Zener; D_0603_1608Metric
D6: SMF24A; D_SMF
D7: 1N4007; D_0603_1608Metric_Pad1.05x0.95mm_HandSolder
JP1, JP2, JP3: SolderJumper_2_Open; SolderJumper-2_P1.3mm_Open_TrianglePad1.0x1.5mm
R26, R29, R35: 10k; R_0201_0603Metric
R27: 100k; R_0201_0603Metric
R28: 15; R_0201_0603Metric
RAI1: 2.5k; R_0201_0603Metric
T1: IRF9310TRPBF; SOIC-8_5.3x5.3mm_P1.27mm
U20: SSOP-10-1EP_3.9x4.9mm_P1mm_EP2.1x3.3mm

Connections:
/0_10OUT/SCLK: U20.1 (SCLK); also elsewhere on the board
/0_10OUT/SDA: U20.2 (SDA); also elsewhere on the board
/mA_AOUTPUT+: D7.1 (K); also elsewhere on the board
GND: C12.2, C13.2, C14.2, C15.2, D6.2 (A2), JP1.1 (A), JP2.1 (A), JP3.1 (A), R27.2, RAI1.2, U20.6 (GND); also elsewhere on the board
unnamed: C14.1, D2.2 (A), R27.1, T1.4
unnamed: C15.1, D6.1 (A1), R28.1, T1.5, T1.6, T1.7, T1.8
unnamed: D7.2 (A), R28.2
unnamed: JP1.2 (B), R29.2, U20.4 (A1)
unnamed: JP2.2 (B), R26.2, U20.3 (A0)
unnamed: JP3.2 (B), R35.2, U20.9 (A2)
unnamed: T1.1, T1.2, T1.3, U20.8 (IOUT)
unnamed: C12.1, RAI1.1, U20.7 (SET)
unnamed: C13.1, R26.1, R29.1, R35.1, U20.10 (V5V)
VCC: D2.1 (K), U20.5 (VCC); also elsewhere on the board

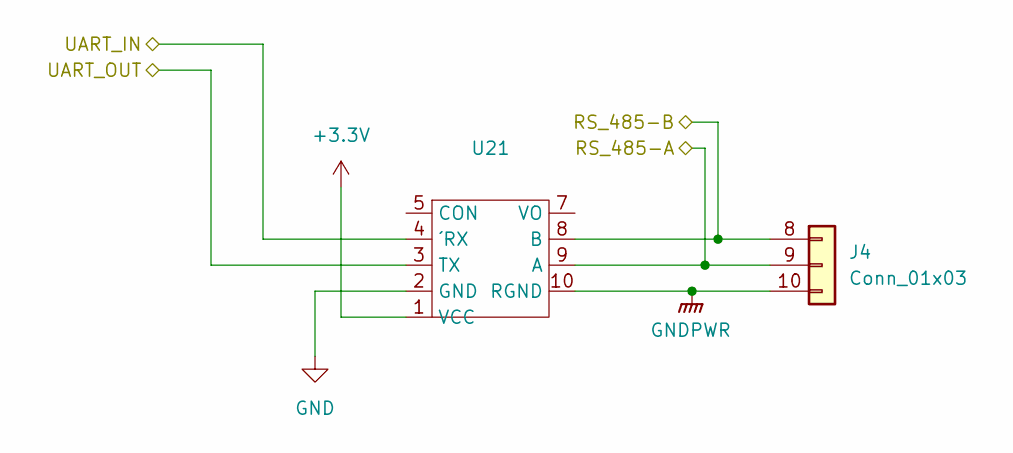
[picture p44: schematic RS_MOD_PRO.kicad_sch]

Parts:
J4: Conn_01x03; PinHeader_1x03_P2.54mm_Vertical
U21: Untitled

Connections:
+3.3V: U21.1 (VCC); also elsewhere on the board
/PLC4UNI/UART_IN: U21.4 (´RX); also elsewhere on the board
/PLC4UNI/UART_OUT: U21.3 (TX); also elsewhere on the board
/RS_485-A: J4.9 (Pin_2), U21.9 (A); also elsewhere on the board
/RS_485-B: J4.8 (Pin_1), U21.8 (B); also elsewhere on the board
GND: U21.2 (GND); also elsewhere on the board
GNDPWR: J4.10 (Pin_3), U21.10 (RGND); also elsewhere on the board

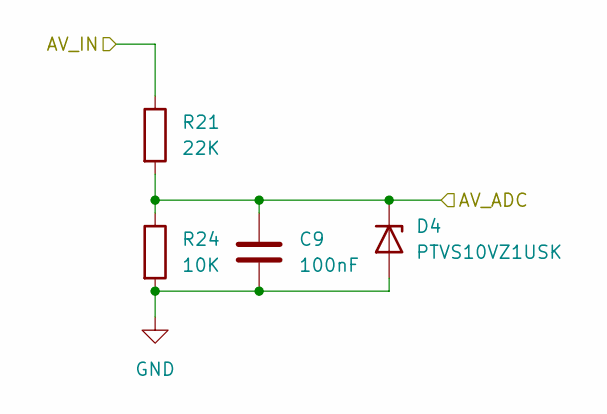
[picture p45: schematic VA.kicad_sch]

Parts:
C9: 100nF; C_0805_2012Metric_Pad1.18x1.45mm_HandSolder
D4: PTVS10VZ1USK; Nexperia_DSN1608-2_1.6x0.8mm
R21: 22K; R_0603_1608Metric
R24: 10K; R_0603_1608Metric

Connections:
/010V/AV_ADC: C9.1, D4.1 (K), R21.2, R24.1; also elsewhere on the board
/AV_IN: R21.1; also elsewhere on the board
GND: C9.2, D4.2 (A), R24.2; also elsewhere on the board

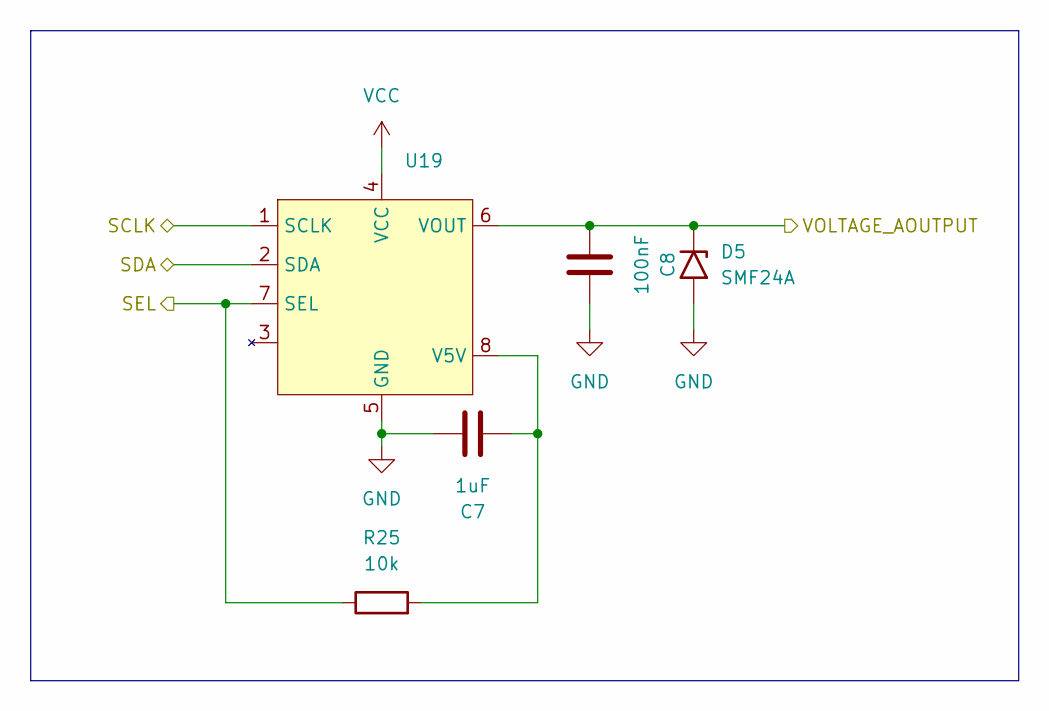
[picture p46: schematic 0_10VOUT.kicad_sch]

Parts:
C7: 1uF; C_0805_2012Metric_Pad1.18x1.45mm_HandSolder
C8: 100nF; C_0805_2012Metric
D5: SMF24A; D_SMF; LCSC# C7495269
R25: 10k; R_0603_1608Metric
U19: SOIC-8_5.3x5.3mm_P1.27mm

Connections:
/0_10OUT/SCLK: U19.1 (SCLK); also elsewhere on the board
/0_10OUT/SDA: U19.2 (SDA); also elsewhere on the board
/0_10OUT/SEL: R25.1, U19.7 (SEL); also elsewhere on the board
/VOLTAGE_AOUTPUT: C8.2, D5.1 (A1), U19.6 (VOUT); also elsewhere on the board
GND: C7.1, C8.1, D5.2 (A2), U19.5 (GND); also elsewhere on the board
unnamed: C7.2, R25.2, U19.8 (V5V)
VCC: U19.4 (VCC); also elsewhere on the board

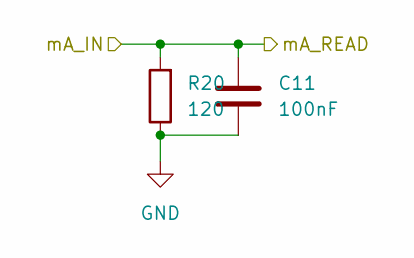
[picture p47: schematic 420.kicad_sch]

Parts:
C11: 100nF; C_0805_2012Metric
R20: 120; R_0603_1608Metric; Tolerance 0.1-1%

Connections:
/mA_IN: C11.1, R20.2; also elsewhere on the board
GND: C11.2, R20.1; also elsewhere on the board

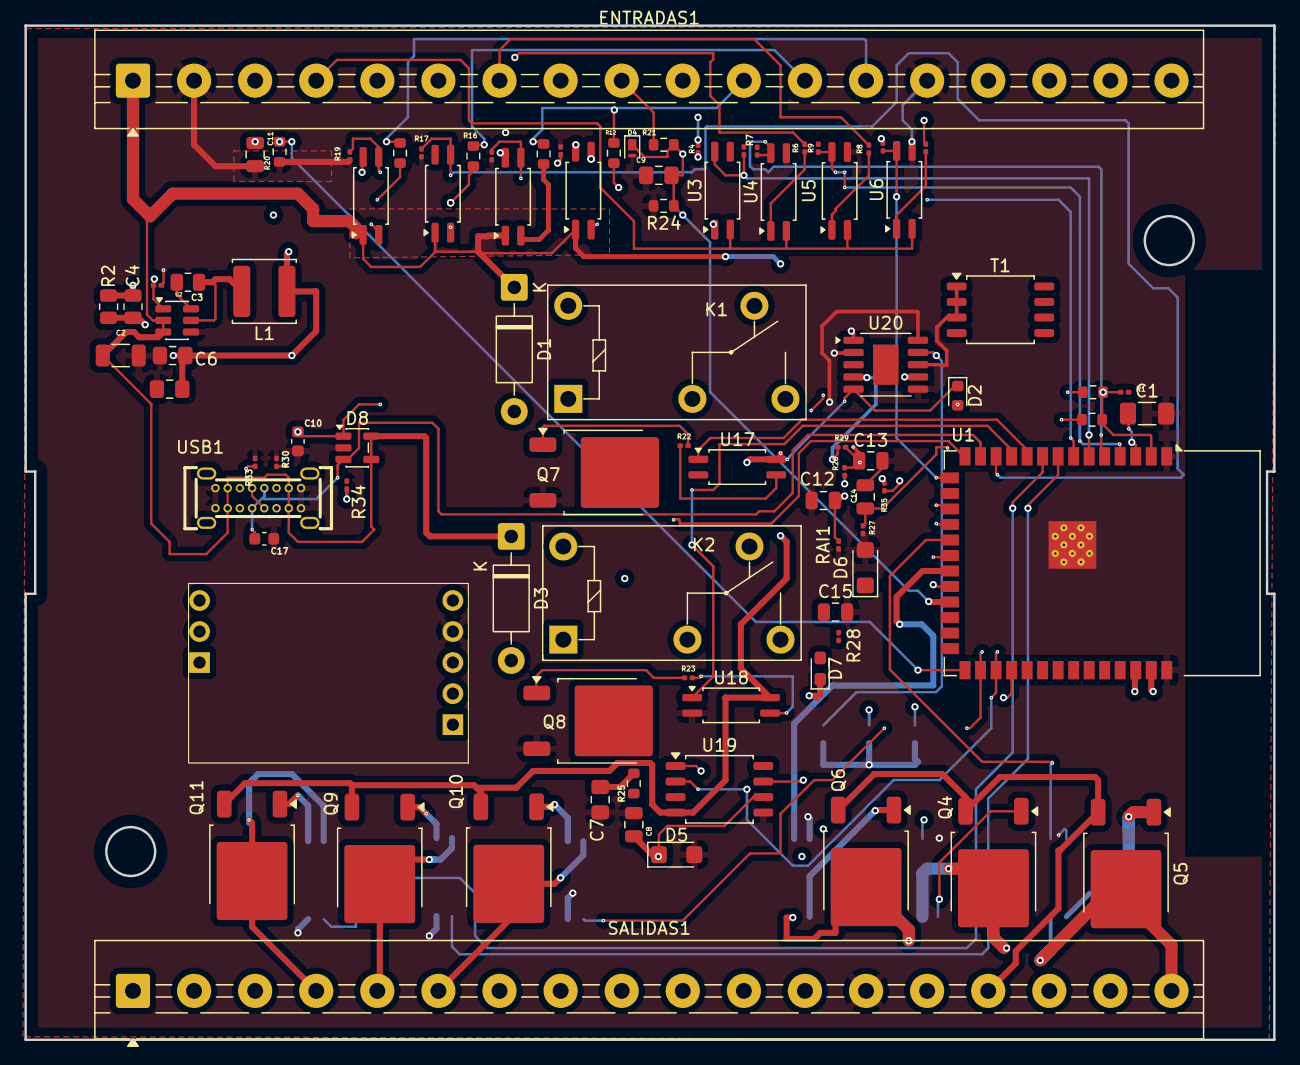
[picture p48: board PLC4UNI_Board.kicad_pcb from above]

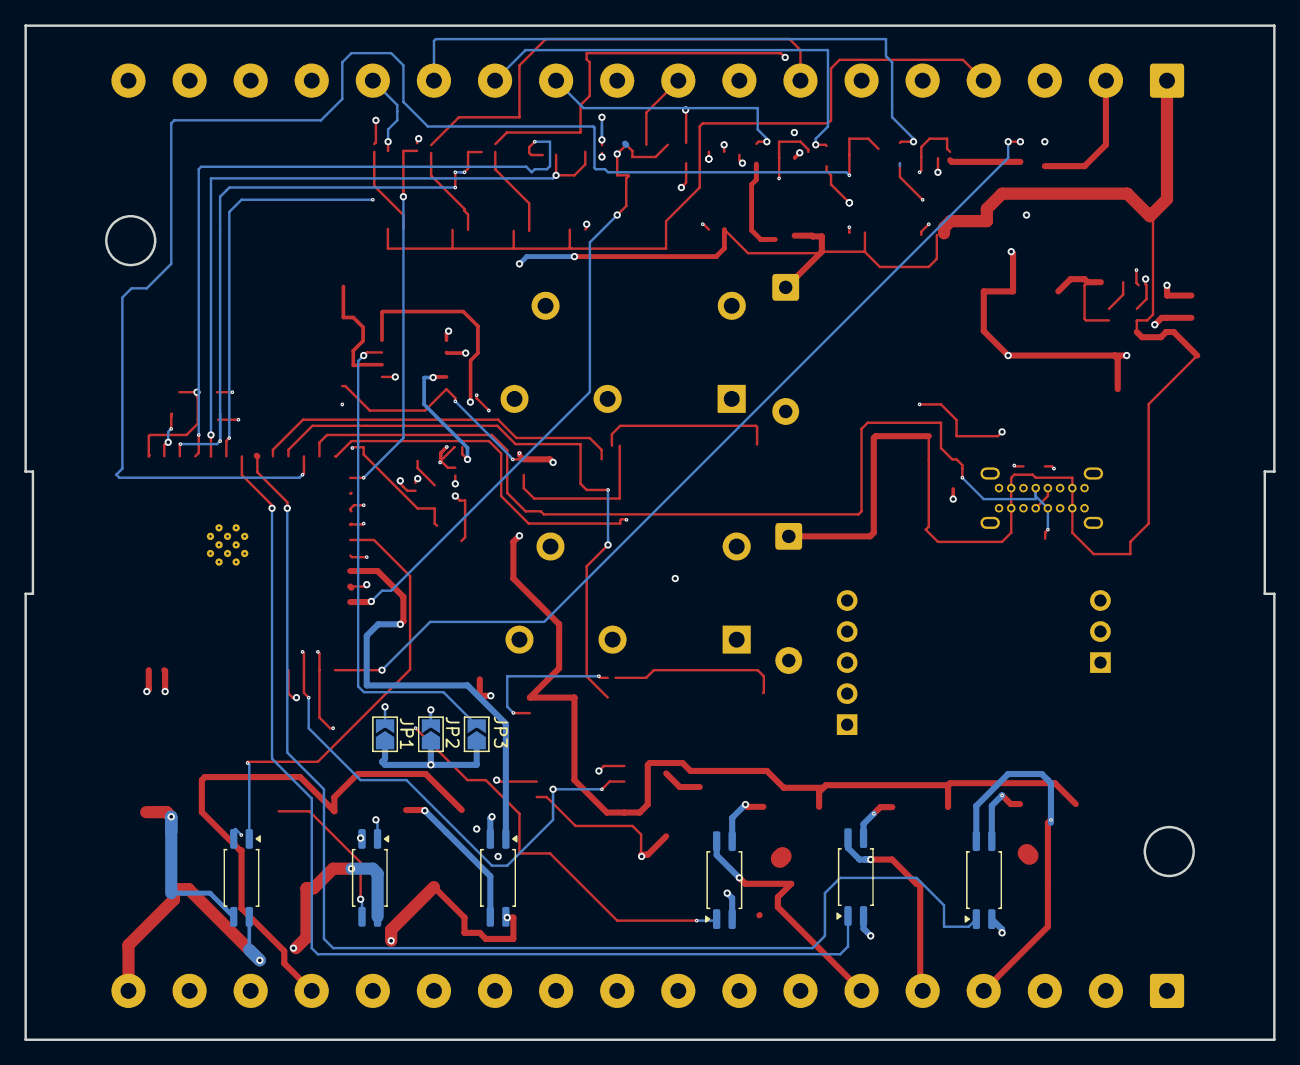
[picture p49: board PLC4UNI_Board.kicad_pcb from below]

Board: 4 copper layers, 102.2 x 83.0 mm, 99 parts (9 on the bottom side), 91 nets.
