NicairolMedinaPayano/nicairol0921/(commit log)

2025-10-10 Delete Definiciones de comandos.pdf
    Sí
2025-10-10 Delete Resúmenes de los capítulos 1,2,3 y 4 de lógica matemática.pdf
    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
2025-10-11 Tarea 1
    Tarea 1: Trabajos teóricos de Word
2025-10-11 Delete Tarea 1. Trabajos teóricos de Word directory
    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
2025-10-11 Tarea 2. Video, Ensamblajes FreeCAD y Solid Edge
    [Parte 1.FCStd, Parte 2.FCStd, Parte 3.FCStd]
